patrickfleischmann/microcntr_pcb_kicad/README.md

# microcntr_pcb_kicad
PCB design files KiCad

[Kicanvas](https://kicanvas.org/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)

Application: KiCad (64-bit), Version: (6.0.7), release build
