patrickfleischmann/microcntr_pcb_kicad/Digikey/82608084.xlsx

# | QUANTITY | PART NUMBER | MANUFACTURER PART NUMBER | DESCRIPTION | CUSTOMER REFERENCE | BACKORDER | UNIT PRICE | EXTENDED PRICE
1 | 10 | 1276-1595-1-ND | CL05C010CB5NNNC | CAP CER 1PF 50V C0G/NP0 0402 |  | 0 | 0.029 | 0,29 Fr.
2 | 20 | 490-10471-1-ND | GRM188C80J226ME15D | CAP CER 22UF 6.3V X6S 0603 |  | 0 | 0.129 | 2,58 Fr.
3 | 1 | CM1213A-04S7OSCT-ND | CM1213A-04S7 | TVS DIODE 3.3VWM 10V SC88/SC70-6 |  | 0 | 0.45 | 0,45 Fr.
4 | 10 | 3147-B2841UYG-20D000514U1930CT-ND | B2841UYG-20D000514U1930 | 1.0(L)X0.5(W)X0.5(H) MM |  | 0 | 0.055 | 0,55 Fr.
5 | 1 | 490-1066-1-ND | DLW21HN181SQ2L | CMC 250MA 2LN 180 OHM SMD |  | 0 | 0.41 | 0,41 Fr.
6 | 1 | 505-ADF4156BRUZ-ND | ADF4156BRUZ | IC FRACT N SYNTH 16TSSOP |  | 0 | 8.11 | 8,11 Fr.
7 | 3 | 505-ADM7160AUJZ-3.3-R7CT-ND | ADM7160AUJZ-3.3-R7 | IC REG LINEAR 3.3V 200MA TSOT5 |  | 0 | 1.68 | 5,04 Fr.
8 | 1 | 497-6349-1-ND | M24512-RDW6TP | IC EEPROM 512KBIT I2C 8TSSOP |  | 0 | 0.76 | 0,76 Fr.
9 | 1 | 102-3761-1-ND | CPT-9019S-SMT-TR | BUZZER PIEZO 3V 9X9MM SMD |  | 0 | 1.41 | 1,41 Fr.
10 | 2 | 1727-BC69PASXCT-ND | BC69PASX | TRANS PNP 20V 2A DFN2020D-3 |  | 0 | 0.32 | 0,64 Fr.
11 | 1 | BCV62CE6327HTSA1CT-ND | BCV62CE6327HTSA1 | TRANS 2PNP 30V 0.1A SOT143 |  | 0 | 0.39 | 0,39 Fr.
12 | 2 | 568-BFU550WFCT-ND | BFU550WF | RF TRANS NPN 12V 11GHZ SOT323-3 |  | 0 | 0.52 | 1,04 Fr.
13 | 2 | YAG3343CT-ND | RT0402FRE0727RL | RES SMD 27 OHM 1% 1/16W 0402 |  | 0 | 0.09 | 0,18 Fr.
14 | 10 | YAG1233CT-ND | RT0402FRE0710KL | RES SMD 10K OHM 1% 1/16W 0402 |  | 0 | 0.061 | 0,61 Fr.
15 | 15 | YAG5931CT-ND | RT0402FRE0722KL | RES SMD 22K OHM 1% 1/16W 0402 |  | 0 | 0.061 | 0,92 Fr.
16 | 10 | YAG5933CT-ND | RT0402FRE0733KL | RES SMD 33K OHM 1% 1/16W 0402 |  | 0 | 0.061 | 0,61 Fr.
17 | 2 | 576-3037-1-ND | MIC94065YC6-TR | IC PWR SWITCH P-CHAN 1:1 SC70-6 |  | 0 | 0.6 | 1,20 Fr.
18 | 1 | 768-1135-1-ND | FT230XS-R | IC USB SERIAL BASIC UART 16SSOP |  | 0 | 1.97 | 1,97 Fr.
19 | 1 | 296-38164-1-ND | LMT85DCKR | SENSOR ANALOG -50C-150C SC70-5 |  | 0 | 0.7 | 0,70 Fr.
20 | 4 | 296-48165-1-ND | SN74LVC1G80QDCKRQ1 | IC FF D-TYPE SNGL 1BIT SC70-5 |  | 0 | 0.43 | 1,72 Fr.
21 | 3 | 296-15582-1-ND | SN74LVC1G97DCKR | IC CONFIG MULT-FUNC GATE SC70-6 |  | 0 | 0.34 | 1,02 Fr.
22 | 1 | 497-16239-ND | STM32F410RBT6 | IC MCU 32BIT 128KB FLASH 64LQFP |  | 0 | 5.17 | 5,17 Fr.
23 | 1 | 296-TLV3601DCKRCT-ND | TLV3601DCKR | IC COMPARATOR 1 GEN PUR SC70-5 |  | 0 | 4 | 4,00 Fr.
24 | 3 | 296-TLV9162IDDFRCT-ND | TLV9162IDDFR | DUAL, 16-V, 10-MHZ, RAIL-TO-RAIL |  | 0 | 1.2 | 3,60 Fr.
25 | 10 | 1276-1699-1-ND | CL05C470JB5NNNC | CAP CER 47PF 50V C0G/NP0 0402 |  | 0 | 0.012 | 0,12 Fr.
26 | 1 | 1528-4650-ND | 4650 | ADAFRUIT FEATHERWING OLED - 128X |  | 0 | 13.01 | 13,01 Fr.
