patrickfleischmann/microcntr_pcb_kicad/microcntr.kicad_pcb

## KiCad design microcntr.kicad_pcb (2024-06-12)

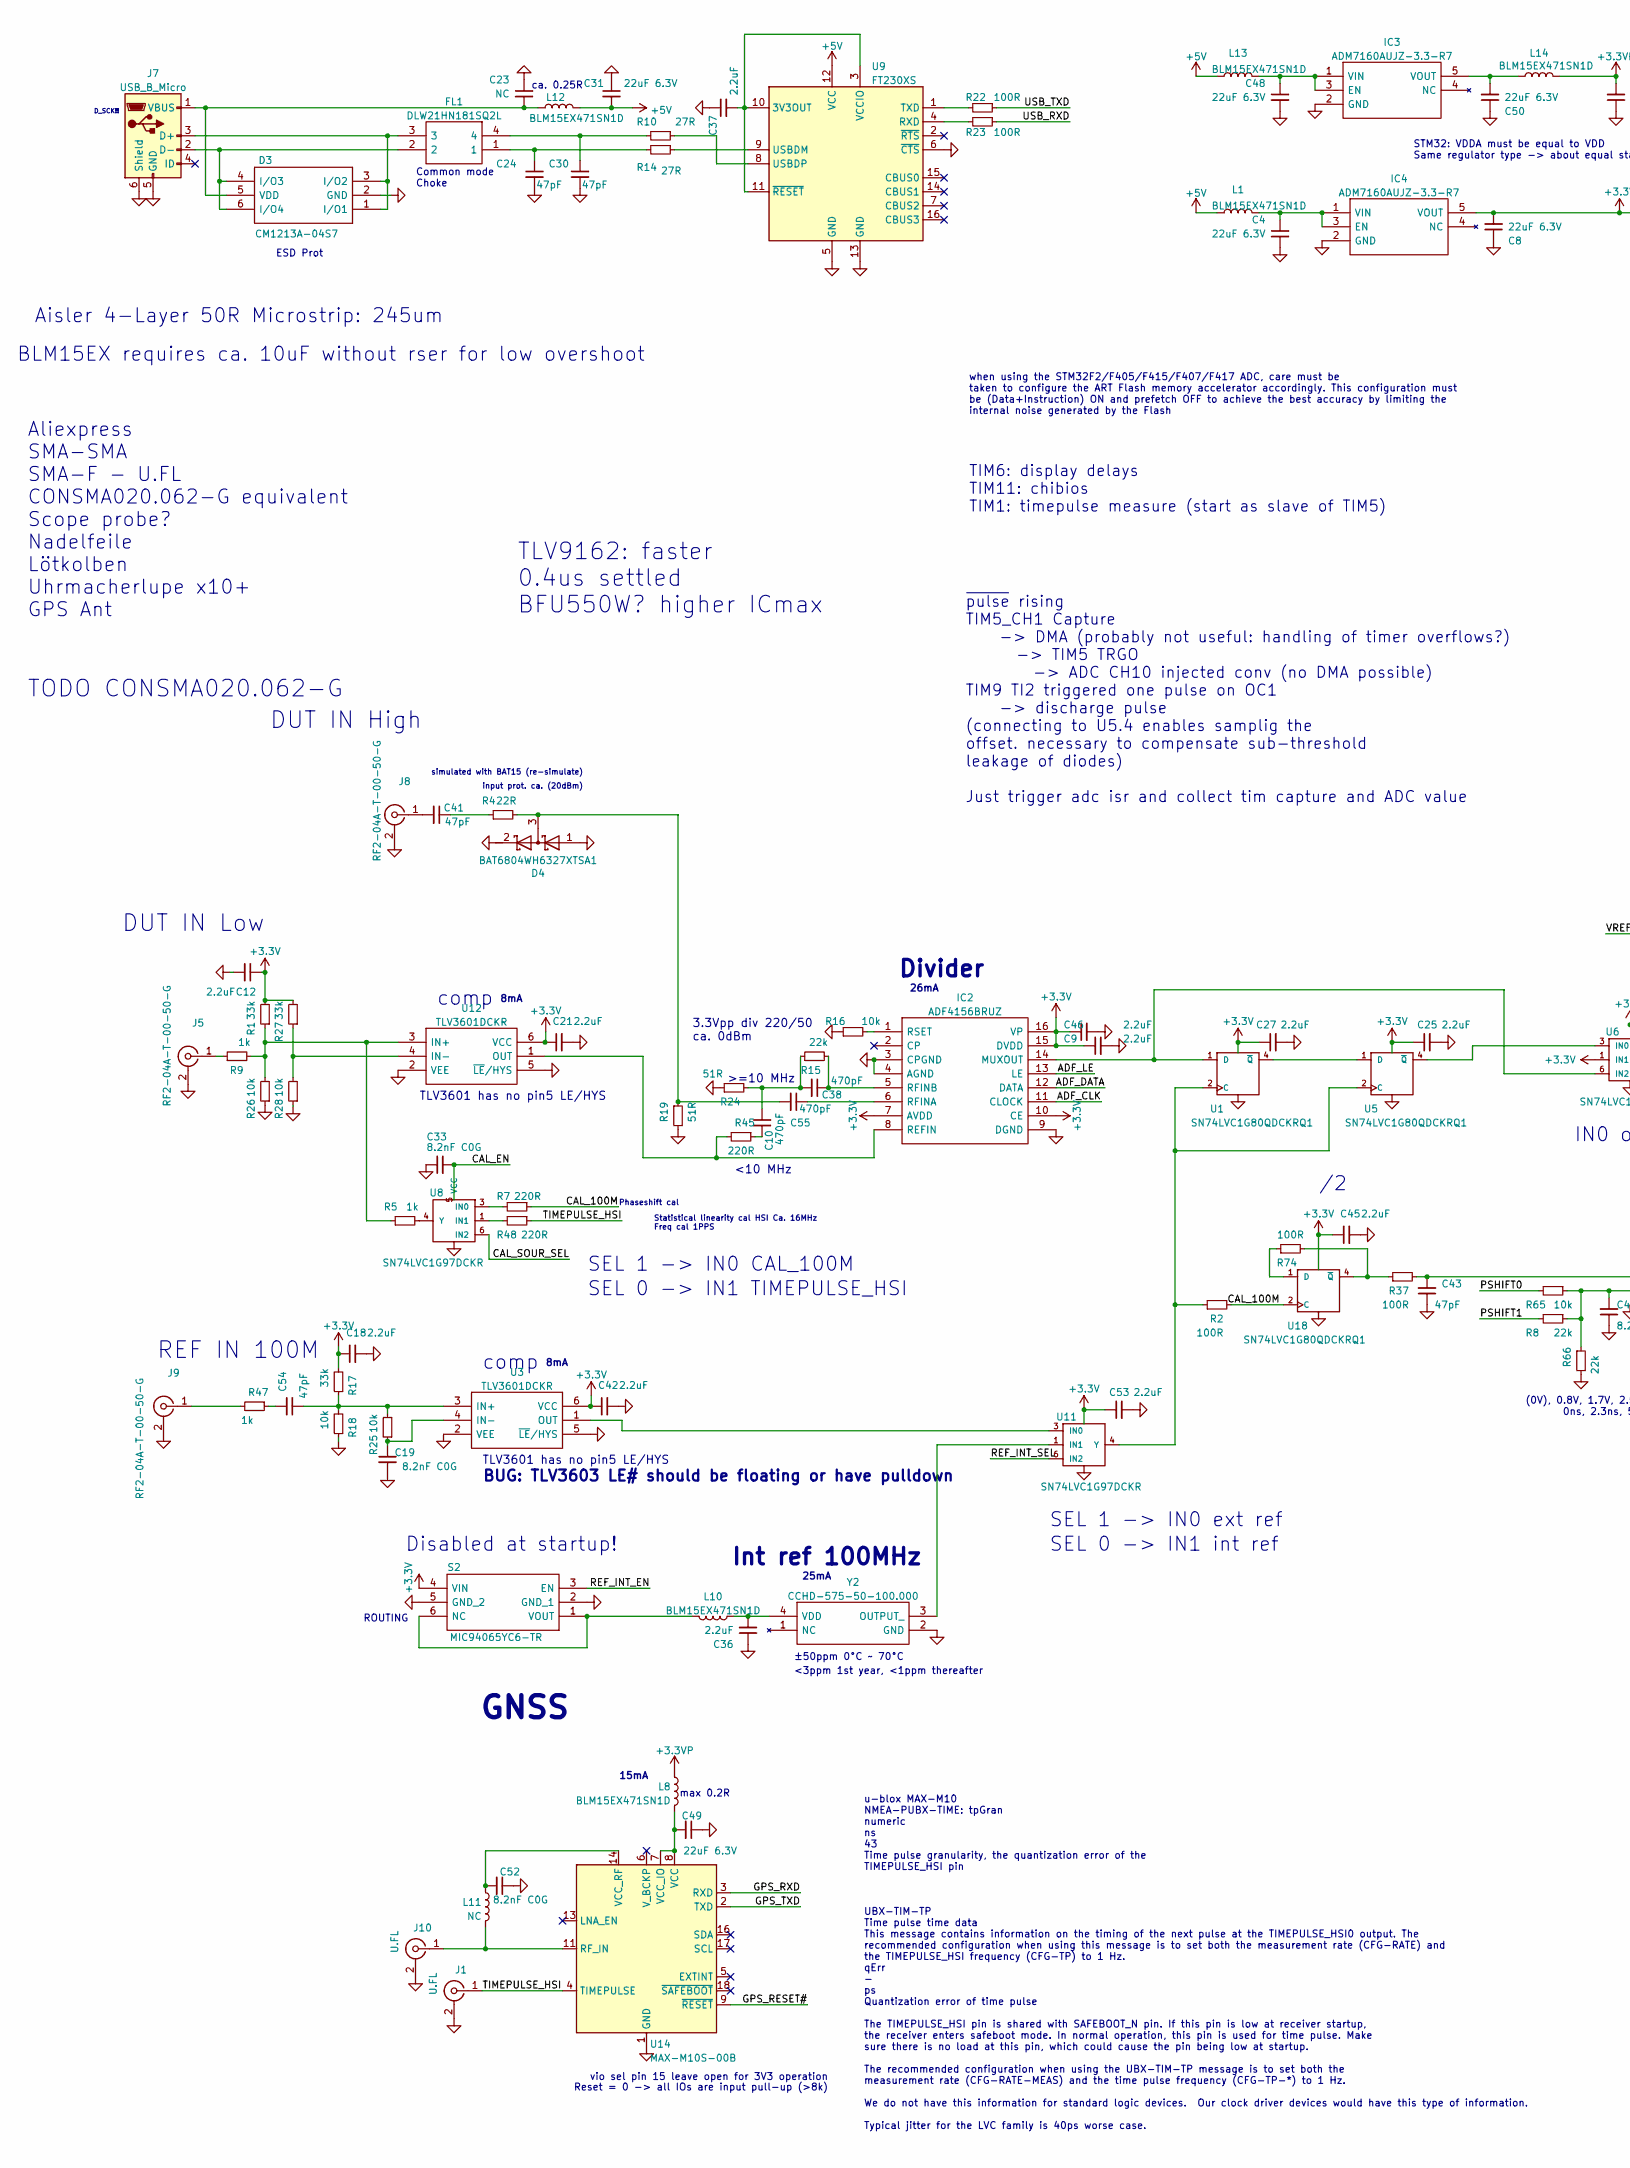
[picture p1: schematic microcntr.kicad_sch, part in row 1, column 1]

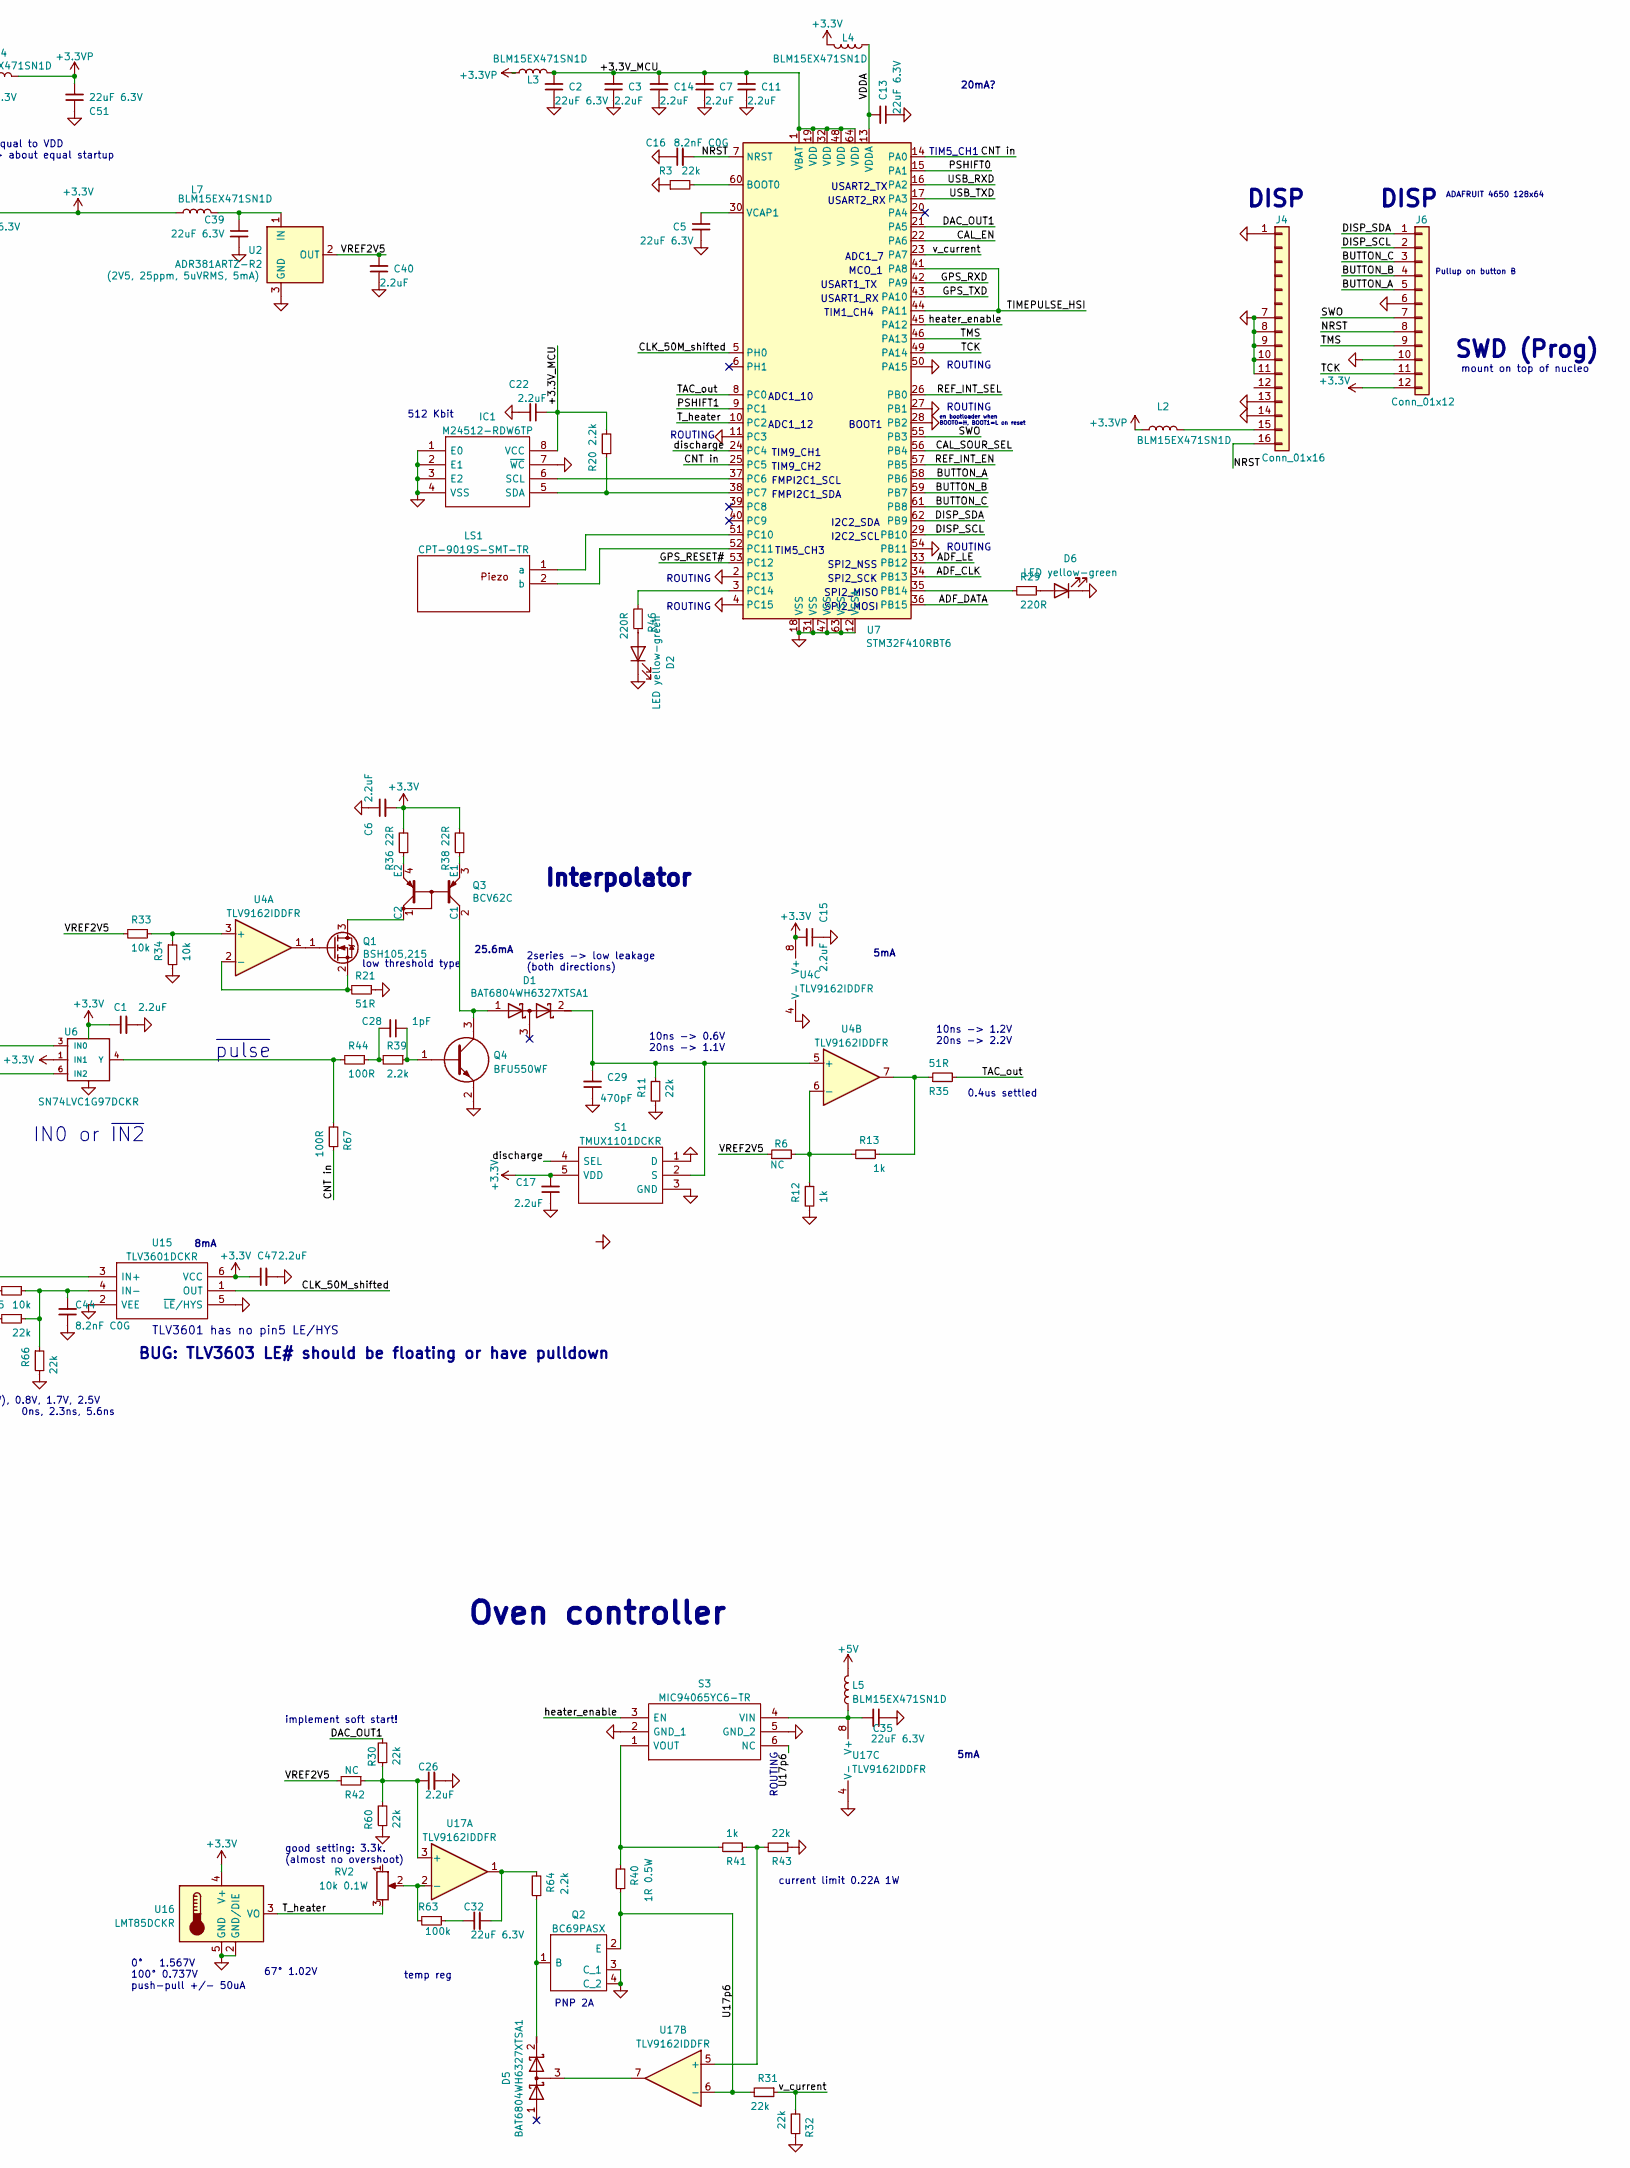
[picture p2: schematic microcntr.kicad_sch, part in row 1, column 2]

Parts:
C1, C3, C6, C7, C9, C11, C12, C14, C15, C17, C18, C22, C25, C26, C27, C36, C37, C40, C45, C46, C47, C53: 2.2uF; C_0402_1005Metric; Manufacturer_Part_Number CL05A225MQ5NNNC; Digikey 1276-1469-1-ND
C2, C4, C5, C8, C13, C31, C32, C35, C39, C48, C49, C50, C51: 22uF 6.3V; C_0603_1608Metric; Manufacturer_Part_Number GRM188C80J226ME15; Digikey 490-10471-1-ND
C10, C38, C55: 470pF; C_0402_1005Metric
C16: 8.2nF C0G; C_0402_1005Metric; Manufacturer_Part_Number GRM1555C1H822JE01D; Digikey 1276-1469-1-ND
C19, C33, C41, C44, C52: 8.2nF C0G; C_0402_1005Metric; Manufacturer_Part_Number GRM1555C1H822JE01D; Digikey 490-GRM1555C1H822JE01DCT-ND
C21, C42: 2.2uF; R_0402_1005Metric; Manufacturer_Part_Number CL05A225MQ5NNNC; Digikey 1276-1469-1-ND
C23: NC; C_0402_1005Metric
C24, C30, C43, C54: 47pF; C_0402_1005Metric; Manufacturer_Part_Number CL05C470JB5NNNC; Digikey 1276-1699-1-ND
C28: 1pF; R_0402_1005Metric; Manufacturer_Part_Number CL05C010CB5NNNC; Digikey 1276-1595-1-ND
C29: 470pF; C_0402_1005Metric; Manufacturer_Part_Number 0402N471G500CT; Digikey 1292-1327-1-ND
D1, D4, D5: BAT6804WH6327XTSA1; SOT-323_SC-70; Manufacturer_Part_Number BAT6804WH6327XTSA1; Digikey BAT6804WH6327XTSA1CT-ND
D2, D6: LED yellow-green; LED_0402_1005Metric; Manufacturer_Part_Number B2841UYG-20D000514U1930; Digikey 3147-B2841UYG-20D000514U1930CT-ND
D3: CM1213A-04S7; SOT-363_SC-70-6; Mouser Part Number CM1213A−04S7
FL1: DLW21HN181SQ2L; DLW21HN121HQ2B; Mouser Part Number 81-DLW21HN181SQ2L
IC1: M24512-RDW6TP; SOP65P640X120-8N; Mouser Part Number 511-M24512-RDW6TP
IC2: ADF4156BRUZ; SOP65P640X120-16N; Mouser Part Number 584-ADF4156BRUZ
IC3, IC4: ADM7160AUJZ-3.3-R7; SOT95P280X100-5N; Mouser Part Number 584-ADM7160AUJZ3.3R7
J1, J10: U.FL; U.FL_Molex_MCRF_73412-0110_Vertical; Manufacturer_Part_Number 0734120110; Digikey WM5587CT-ND
J4: Conn_01x16; PinSocket_1x16_P2.54mm_Vertical
J5, J8, J9: RF2-04A-T-00-50-G; CONSMA020062G; Manufacturer_Part_Number RF2-04A-T-00-50-G
J6: Conn_01x12; PinSocket_1x12_P2.54mm_Vertical
J7: USB_B_Micro; USB_Micro-B_Amphenol_10103594-0001LF_Horizontal; Manufacturer_Part_Number 10103594-0001LF; Digikey 609-4050-1-ND
L1, L2, L3, L4, L5, L7, L8, L10, L12, L13, L14: BLM15EX471SN1D; L_0402_1005Metric; Manufacturer_Part_Number BLM15EX471SN1D; Digikey 490-BLM15EX471SN1DCT-ND
L11: NC; L_0402_1005Metric
LS1: CPT-9019S-SMT-TR; CPT9019SSMTTR; Mouser Part Number 490-CPT-9019S-SMT-TR
Q1: BSH105,215; SOT-23; Manufacturer_Part_Number BSH105,215; Digikey 1727-4924-1-ND
Q2: BC69PASX; Mouser Part Number 771-BC69PASX
Q3: BCV62C; SOT-143; Manufacturer_Part_Number BCV62CE6327HTSA1; Digikey BCV62CE6327HTSA1CT-ND
Q4: BFU550WF; SOT65P210X110-3N; Mouser Part Number 771-BFU550WF
R1, R17, R27: 33k; R_0402_1005Metric; Manufacturer_Part_Number RT0402FRE0733KL; Digikey YAG5933CT-ND
R2: 100R; R_0402_1005Metric; Manufacturer_Part_Number RT0402FRE07100RL; Digikey 13-RT0402FRE07220RLCT-ND
R3, R8, R11, R15, R30, R31, R32, R43, R60, R66: 22k; R_0402_1005Metric; Manufacturer_Part_Number RT0402FRE0722KL; Digikey YAG5931CT-ND
R4, R36, R38: 22R; R_0402_1005Metric; Manufacturer_Part_Number RT0402FRE0722KL; Digikey YAG5931CT-ND
R5: 1k; R_0402_1005Metric; Manufacturer_Part_Number RT0402FRE0710KL; Digikey YAG1233CT-ND
R6: NC; R_0402_1005Metric; Digikey YAG1233CT-ND
R7, R29, R45, R46, R48: 220R; R_0402_1005Metric; Manufacturer_Part_Number RT0402FRE07220RL; Digikey 13-RT0402FRE07220RLCT-ND
R9, R12, R41: 1k; R_0402_1005Metric; Manufacturer_Part_Number RT0402FRE071KL; Digikey YAG1234CT-ND
R10, R14: 27R; R_0402_1005Metric; Manufacturer_Part_Number RT0402FRE0751RL; Digikey YAG3343CT-ND
R13: 1k; R_0402_1005Metric; Manufacturer_Part_Number RT0402FRE071KL; Digikey 13-RT0402FRE072K2LCT-ND
R16, R18, R25, R26, R28, R33, R34, R65: 10k; R_0402_1005Metric; Manufacturer_Part_Number RT0402FRE0710KL; Digikey YAG1233CT-ND
R19, R21, R24, R35: 51R; R_0402_1005Metric; Manufacturer_Part_Number RT0402FRE0751RL; Digikey 13-RT0402FRE0751RLCT-ND
R20, R39, R64: 2.2k; R_0402_1005Metric; Manufacturer_Part_Number RT0402FRE072K2L; Digikey 13-RT0402FRE072K2LCT-ND
R22, R23, R37, R44, R67, R74: 100R; R_0402_1005Metric; Manufacturer_Part_Number RT0402FRE07100RL; Digikey YAG3342CT-ND
R40: 1R 0.5W; R_0805_2012Metric; Manufacturer_Part_Number ERJ-6DQJ1R0V; Digikey P19220CT-ND
R42: NC; R_0402_1005Metric; Manufacturer_Part_Number RT0402FRE0722KL; Digikey YAG5931CT-ND
R47: 1k; R_0402_1005Metric; Manufacturer_Part_Number YAG1234CT-ND; Digikey 13-RT0402FRE07220RLCT-ND
R63: 100k; R_0402_1005Metric; Manufacturer_Part_Number RT0402FRE07100KL; Digikey YAG2307CT-ND
RV2: 10k 0.1W; Potentiometer_Bourns_3214J_Horizontal; Manufacturer_Part_Number 3214J-2-103E; Digikey 118-3214J-2-103ECT-ND
S1: TMUX1101DCKR; SOT65P210X110-5N; Mouser Part Number 595-TMUX1101DCKR
S2, S3: MIC94065YC6-TR; SOT65P210X110-6N; Mouser Part Number 998-MIC94065YC6TR
U1, U5, U18: SN74LVC1G80QDCKRQ1; SOT-353_SC-70-5; Manufacturer_Part_Number SN74LVC1G80QDCKRQ1; Digikey 296-48165-1-ND
U2: ADR381ARTZ-R2; SOT-23; Manufacturer_Part_Number ADR381ARTZ-R2; Digikey 505-ADR381ARTZ-R2CT-ND
U3, U12, U15: TLV3601DCKR; SOT-363_SC-70-6; Mouser Part Number 595-TLV3603DCKR
U4, U17: TLV9162IDDFR; SOT65P280X110-8N; Manufacturer_Part_Number TLV9162IDDFR; Digikey 296-TLV9162IDDFRCT-ND
U6, U8, U11: SN74LVC1G97DCKR; SOT-363_SC-70-6; Manufacturer_Part_Number SN74LVC1G97DCKR; Digikey 296-15582-1-ND
U7: STM32F410RBT6; LQFP-64_10x10mm_P0.5mm; Manufacturer_Part_Number STM32F410RBT6; Digikey 497-16239-ND
U9: FT230XS; SSOP-16_3.9x4.9mm_P0.635mm; Manufacturer_Part_Number FT230XS-R; Digikey 768-1135-1-ND
U14: MAX-M10S-00B; ublox_MAX; Manufacturer_Part_Number MAX-M10S-00B; Digikey 672-MAX-M10S-00BCT-ND
U16: LMT85DCKR; SOT-353_SC-70-5; Manufacturer_Part_Number LMT85DCKR; Digikey 296-38164-1-ND
Y2: CCHD-575-50-100.000; CCHD57550100000; Mouser Part Number 549-CCHD-575-50-100

Connections:
+3.3V: C1.1, C6.2, C8.2, C9.1, C12.1, C15.2, C17.2, C18.1, C21.1, C25.1, C27.1, C42.1, C45.1, C46.1, C47.1, C53.1, IC2.7 (AVDD), IC2.10 (CE), IC2.15 (DVDD), IC2.16 (VP), IC4.5 (VOUT), J6.12, L4.2, L7.1, R1.2, R17.2, R27.2, R36.2, R38.2, S1.5 (VDD), S2.4 (VIN), U1.5 (VCC), U3.6 (VCC), U4.8 (V+), U5.5 (VCC), U6.1 (IN1), U6.5 (VCC), U11.5 (VCC), U12.6 (VCC), U15.6 (VCC), U16.4 (V+), U18.5 (VCC)
+3.3VP: C51.2, L2.1, L3.1, L8.2, L14.2
+5V: C31.2, L1.1, L5.2, L12.2, L13.1, U9.12 (VCC)
/+3.3V_MCU: C2.2, C3.2, C7.2, C11.2, C14.2, C22.1, IC1.8 (VCC), L3.2, R20.2, U7.1 (VBAT), U7.19 (VDD), U7.32 (VDD), U7.48 (VDD), U7.64 (VDD)
/ADF_CLK: IC2.11 (CLOCK), U7.34 (PB13)
/ADF_DATA: IC2.12 (DATA), U7.36 (PB15)
/ADF_LE: IC2.13 (LE), U7.33 (PB12)
/BUTTON_A: J6.5, U7.58 (PB6)
/BUTTON_B: J6.4, U7.59 (PB7)
/BUTTON_C: J6.3, U7.61 (PB8)
/CAL_100M: R2.2, R7.1, U18.2 (C)
/CAL_EN: C33.2, U7.22 (PA6), U8.5 (VCC)
/CAL_SOUR_SEL: U7.56 (PB4), U8.6 (IN2)
/CLK_50M_shifted: U7.5 (PH0), U15.1 (OUT)
/CNT in: R67.1, U7.14 (PA0), U7.25 (PC5)
/DAC_OUT1: R30.2, U7.21 (PA5)
/DISP_SCL: J6.2, U7.29 (PB10)
/DISP_SDA: J6.1, U7.62 (PB9)
/GPS_RESET#: U7.53 (PC12), U14.9 (~RESET)
/GPS_RXD: U7.42 (PA9), U14.3 (RXD)
/GPS_TXD: U7.43 (PA10), U14.2 (TXD)
/NRST: C16.2, J4.16, J6.8, U7.7 (NRST)
/PSHIFT0: R65.2, U7.15 (PA1)
/PSHIFT1: R8.2, U7.9 (PC1)
/REF_INT_EN: S2.3 (EN), U7.57 (PB5)
/REF_INT_SEL: U7.26 (PB0), U11.6 (IN2)
/SWO: J6.7, U7.55 (PB3)
/TAC_out: R35.2, U7.8 (PC0)
/TCK: J6.11, U7.49 (PA14)
/TIMEPULSE_HSI: J1.1 (In), R48.1, U7.41 (PA8), U7.44 (PA11), U14.4 (TIMEPULSE)
/TMS: J6.9, U7.46 (PA13)
/T_heater: RV2.3, U7.10 (PC2), U16.3 (VO)
/U17p6: Q2.2 (E), R31.2, R40.1, S3.6 (NC), U17.6 (-)
/USB_RXD: R23.1, U7.16 (PA2)
/USB_TXD: R22.1, U7.17 (PA3)
/VDDA: C13.2, L4.1, U7.13 (VDDA)
/VREF2V5: C40.2, R6.1, R33.2, R42.2, U2.2 (OUT)
/discharge: S1.4 (SEL), U7.24 (PC4)
/heater_enable: S3.3 (EN), U7.45 (PA12)
/v_current: R31.1, R32.2, U7.23 (PA7)
GND: C1.2, C2.1, C3.1, C4.2, C5.2, C6.1, C7.1, C8.1, C9.2, C11.1, C12.2, C13.1, C14.1, C15.1, C16.1, C17.1, C18.2, C19.2, C21.2, C22.2, C23.1, C24.2, C25.2, C26.2, C27.2, C29.1, C30.2, C31.1, C33.1, C35.1, C36.1, C37.1, C39.2, C40.1, C42.2, C43.1, C44.1, C45.2, C46.2, C47.2, C48.2, C49.1, C50.1, C51.1, C52.1, C53.2, D2.1 (K), D3.2 (GND), D4.1 (A), D4.2 (K), D6.1 (K), IC1.1 (E0), IC1.2 (E1), IC1.3 (E2), IC1.4 (VSS), IC1.7 (~WC), IC2.3 (CPGND), IC2.4 (AGND), IC2.9 (DGND), IC3.2 (GND), IC4.2 (GND), J1.2 (Ext), J4.1, J4.7, J4.8, J4.9, J4.10, J4.11, J4.13, J4.14, J5.2 (Ext), J6.6, J6.10, J7.5 (GND), J7.6 (Shield), J8.2 (Ext), J9.2 (Ext), J10.2 (Ext), Q2.3 (C_1), Q2.4 (C_2), Q4.2, R3.1, R11.2, R12.2, R16.1, R18.1, R19.2, R21.1, R24.1, R26.1, R28.1, R32.1, R34.2, R43.1, R60.1, R66.2, S1.1 (D), S1.3 (GND), S2.2 (GND_1), S2.5 (GND_2), S3.2 (GND_1), S3.5 (GND_2), U1.3 (GND), U2.3 (GND), U3.2 (VEE), U3.5 (~LE/HYS), U4.4 (V-), U5.3 (GND), U6.2 (GND), U7.2 (PC13), U7.4 (PC15), U7.11 (PC3), U7.12 (VSSA), U7.18 (VSS), U7.27 (PB1), U7.28 (PB2), U7.31 (VSS), U7.47 (VSS), U7.50 (PA15), U7.54 (PB11), U7.63 (VSS), U8.2 (GND), U9.5 (GND), U9.6 (~CTS), U9.13 (GND), U11.2 (GND), U12.2 (VEE), U12.5 (~LE/HYS), U14.1 (GND), U14.10 (GND), U14.12 (GND), U15.2 (VEE), U15.5 (~LE/HYS), U16.2 (GND/DIE), U16.5 (GND), U17.4 (V-), U18.3 (GND), Y2.2 (GND)
unnamed: C4.1, IC4.1 (VIN), IC4.3 (EN), L1.2
unnamed: C5.1, U7.30 (VCAP1)
unnamed: C10.1, C38.2, R15.1, R24.2
unnamed: C10.2, R45.1
unnamed: C19.1, R25.1, U3.4 (IN-)
unnamed: C23.2, D3.5 (VDD), J7.1 (VBUS), L12.1
unnamed: C24.1, FL1.1, R14.2
unnamed: C26.1, R30.1, R42.1, R60.2, U17.3 (+)
unnamed: C28.1, Q4.1, R39.1
unnamed: C28.2, R39.2, R44.1
unnamed: C29.2, D1.2 (K), R11.1, S1.2 (S), U4.5 (+)
unnamed: C30.1, FL1.4, R10.2
unnamed: C32.1, R63.1
unnamed: C32.2, R64.2, U17.1
unnamed: C35.2, L5.1, S3.4 (VIN), U17.8 (V+)
unnamed: C36.2, L10.2, Y2.4 (VDD)
unnamed: C37.2, U9.3 (VCCIO), U9.10 (3V3OUT), U9.11 (~RESET)
unnamed: C38.1, IC2.5 (RFINB), R15.2
unnamed: C39.1, L7.2, U2.1 (IN)
unnamed: C41.1, R4.1
unnamed: C41.2, J8.1 (In)
unnamed: C43.2, R37.2, U15.3 (IN+)
unnamed: C44.2, R8.1, R65.1, R66.1, U15.4 (IN-)
unnamed: C48.1, IC3.1 (VIN), IC3.3 (EN), L13.2
unnamed: C49.2, L8.1, U14.7 (VCC_IO), U14.8 (VCC)
unnamed: C50.2, IC3.5 (VOUT), L14.1
unnamed: C52.2, L11.2, U14.14 (VCC_RF)
unnamed: C54.1, R17.1, R18.2, R25.2, U3.3 (IN+)
unnamed: C54.2, R47.1
unnamed: C55.1, IC2.6 (RFINA)
unnamed: C55.2, D4.3 (common), R4.2, R19.1
unnamed: D1.1 (A), Q3.2 (C1), Q4.3
unnamed: D2.2 (A), R46.1
unnamed: D3.1 (I/O1), D3.3 (I/O2), FL1.3, J7.3 (D+)
unnamed: D3.4 (I/O3), D3.6 (I/O4), FL1.2, J7.2 (D-)
unnamed: D5.2 (K), Q2.1 (B), R64.1
unnamed: D5.3 (common), U17.7
unnamed: D6.2 (A), R29.1
unnamed: IC1.5 (SDA), R20.1, U7.38 (PC7)
unnamed: IC1.6 (SCL), U7.37 (PC6)
unnamed: IC2.1 (RSET), R16.2
unnamed: IC2.8 (REFIN), R45.2, U12.1 (OUT)
unnamed: IC2.14 (MUXOUT), U1.1 (D), U6.6 (IN2)
unnamed: J4.15, L2.2
unnamed: J5.1 (In), R9.1
unnamed: J9.1 (In), R47.2
unnamed: J10.1 (In), L11.1, U14.11 (RF_IN)
unnamed: L10.1, S2.1 (VOUT), S2.6 (NC)
unnamed: LS1.1 (a), U7.51 (PC10)
unnamed: LS1.2 (b), U7.52 (PC11)
unnamed: Q1.1 (G), U4.1
unnamed: Q1.2 (S), R21.2, U4.2 (-)
unnamed: Q1.3 (D), Q3.1 (C2)
unnamed: Q3.3 (E1), R38.1
unnamed: Q3.4 (E2), R36.1
unnamed: R1.1, R5.1, R9.2, R26.2, U12.3 (IN+)
unnamed: R2.1, U1.2 (C), U5.2 (C), U11.4 (Y)
unnamed: R3.2, U7.60 (BOOT0)
unnamed: R5.2, U8.4 (Y)
unnamed: R7.2, U8.3 (IN0)
unnamed: R10.1, U9.8 (USBDP)
unnamed: R6.2, R12.1, R13.2, U4.6 (-)
unnamed: R13.1, R35.1, U4.7
unnamed: R14.1, U9.9 (USBDM)
unnamed: R22.2, U9.1 (TXD)
unnamed: R23.2, U9.4 (RXD)
unnamed: R27.1, R28.2, U12.4 (IN-)
unnamed: R29.2, U7.35 (PB14)
unnamed: R33.1, R34.1, U4.3 (+)
unnamed: R37.1, R74.2, U18.4 (~Q)
unnamed: R40.2, R41.2, S3.1 (VOUT)
unnamed: R41.1, R43.2, U17.5 (+)
unnamed: R44.2, R67.2, U6.4 (Y)
unnamed: R46.2, U7.3 (PC14)
unnamed: R48.2, U8.1 (IN1)
unnamed: R63.2, RV2.2, U17.2 (-)
unnamed: R74.1, U18.1 (D)
unnamed: U1.4 (~Q), U5.1 (D)
unnamed: U5.4 (~Q), U6.3 (IN0)
unnamed: U11.1 (IN1), Y2.3 (OUTPUT_)
unnamed: U3.1 (OUT), U11.3 (IN0)

Notes on the sheet:
ADC1_10
comp
PNP 2A
512 Kbit
ADC1_7
ESD Prot
Pullup on button B
TLV3601 has no pin5 LE/HYS
temp reg
3.3Vpp div 220/50 ca. 0dBm
Statistical linearity cal HSI Ca. 16MHz Freq cal 1PPS
when using the STM32F2/F405/F415/F407/F417 ADC, care must be taken to configure the ART Flash memory accelerator accordingly. This configuration must be (Data+Instruction) ON and prefetch OFF to achieve the best accuracy by limiting the internal noise generated by the Flash
Oven controller
<3ppm 1st year, <1ppm thereafter
BUG: TLV3603 LE# should be floating or have pulldown
0° 1.567V 100° 0.737V push-pull +/- 50uA
SEL 0 -> IN1 int ref
(0V), 0.8V, 1.7V, 2.5V 0ns, 2.3ns, 5.6ns
D_SCK!!
input prot. ca. (20dBm)
SPI2_NSS
good setting: 3.3k. (almost no overshoot)
DUT IN Low
>=10 MHz
FMPI2C1_SDA
IN0 or ~{IN2}
TIM5_CH3
SWD (Prog)
SEL 1 -> IN0 CAL_100M
Disabled at startup!
SPI2_MISO
SPI2_MOSI
DISP
BOOT1
ROUTING
Interpolator
USART2_TX
TIM5_CH1
I2C2_SDA
Aisler 4-Layer 50R Microstrip: 245um
ADAFRUIT 4650 128x64
MCO_1
USART2_RX
8mA
I2C2_SCL
25mA
Divider
USART1_RX
TIM1_CH4
<10 MHz
15mA
10ns -> 1.2V 20ns -> 2.2V
SEL 1 -> IN0 ext ref
10ns -> 0.6V 20ns -> 1.1V
en bootloader when BOOT0=H, BOOT1=L on reset
TIM9_CH1
FMPI2C1_SCL
vio sel pin 15 leave open for 3V3 operation
SPI2_SCK
20mA?
TIM6: display delays TIM11: chibios TIM1: timepulse measure (start as slave of TIM5)
±50ppm 0°C ~ 70°C
Common mode Choke
u-blox MAX-M10 NMEA-PUBX-TIME: tpGran numeric ns 43 Time pulse granularity, the quantization error of the TIMEPULSE_HSI pin
USART1_TX
Int ref 100MHz
mount on top of nucleo
26mA
~{pulse} rising TIM5_CH1 Capture -> DMA (probably not useful: handling of timer overflows?) -> TIM5 TRGO -> ADC CH10 injected conv (no DMA possible) TIM9 TI2 triggered one pulse on OC1 -> discharge pulse (connecting to U5.4 enables samplig the offset. necessary to compensate sub-threshold leakage o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
67° 1.02V
implement soft start!
ADC1_12
STM32: VDDA must be equal to VDD Same regulator type -> about equal startup
TODO CONSMA020.062-G
BLM15EX requires ca. 10uF without rser for low overshoot
simulated with BAT15 (re-simulate)
DUT IN High
GNSS
REF IN 100M
Phaseshift cal
TIM9_CH2
Reset = 0 -> all IOs are input pull-up (>8k)
25.6mA
low threshold type
Aliexpress SMA-SMA SMA-F - U.FL CONSMA020.062-G equivalent Scope probe? Nadelfeile Lötkolben Uhrmacherlupe x10+ GPS Ant
0.4us settled
TLV9162: faster 0.4us settled BFU550W? higher ICmax
~{pulse}
UBX-TIM-TP Time pulse time data This message contains information on the timing of the next pulse at the TIMEPULSE_HSI0 output. The recommended configuration when using this message is to set both the measurement rate (CFG-RATE) and the TIMEPULSE_HSI frequency (CFG-TP) to 1 Hz. qErr - ps Quantizati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
5mA
SEL 0 -> IN1 TIMEPULSE_HSI
current limit 0.22A 1W
max 0.2R
2series -> low leakage (both directions)
ca. 0.25R

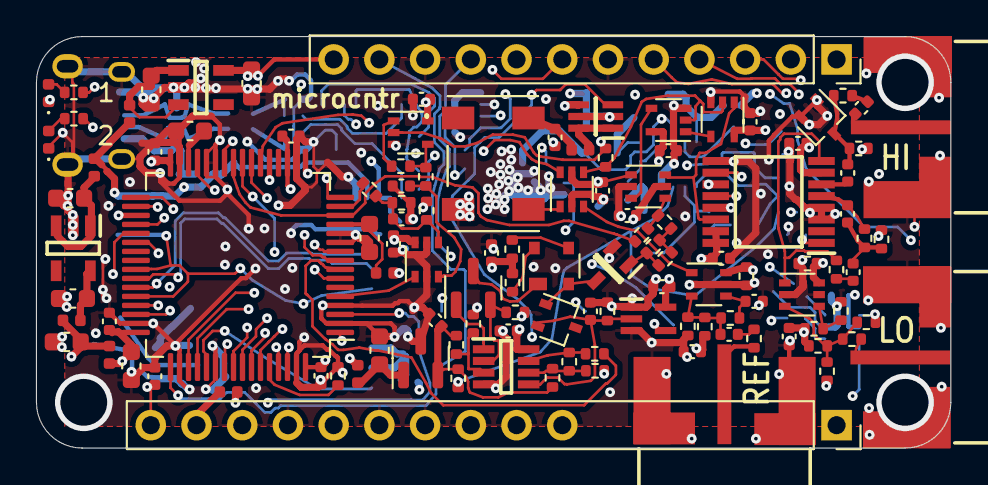
[picture p3: board microcntr.kicad_pcb from above]

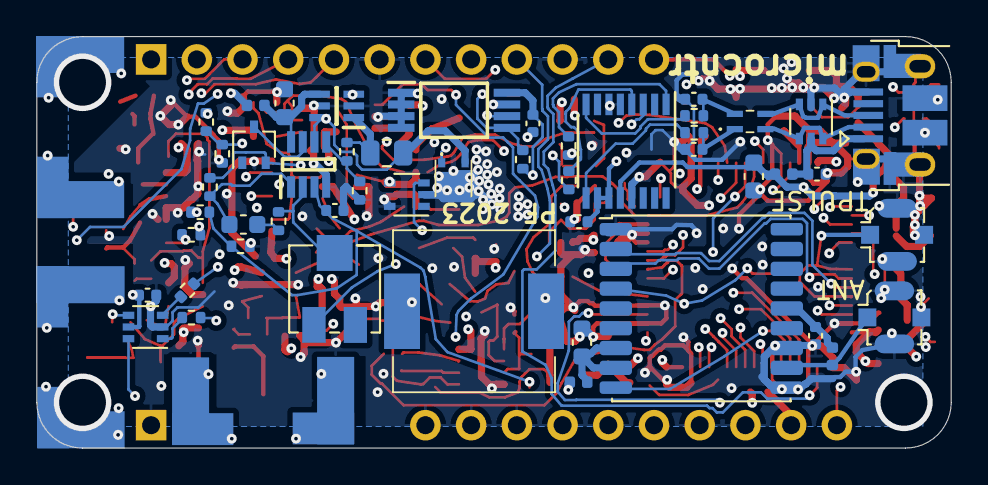
[picture p4: board microcntr.kicad_pcb from below]

Board: 6 copper layers, 50.8 x 22.9 mm, 165 parts (49 on the bottom side), 122 nets.
