patrickfleischmann/microcntr_pcb_kicad/(commit log)

2023-09-30 corrected header rotation
    [microcntr.kicad_pcb]
2023-10-04 added buglist
    [microcntr.kicad_sch]
2024-03-13 buglist new bugs
    [microcntr.kicad_sch]
2024-03-17 added comments
    [microcntr.kicad_sch]
2024-03-18 new buglist entries
    [microcntr.kicad_sch]
2024-03-22 filled in buglist
    [microcntr.kicad_sch]
2024-03-29 added comment
    [microcntr.kicad_sch]
2024-06-12 some comments
    [microcntr.kicad_pcb, microcntr.kicad_sch]
